russianrovercup/kosmo-arm/media/kosmo-arm-r1.jpg

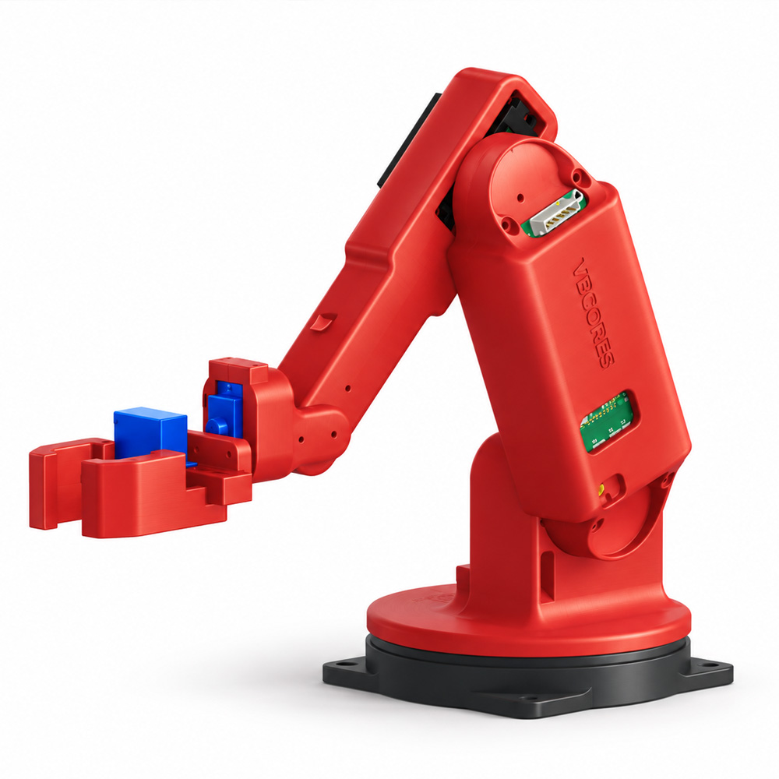
media/kosmo-arm-r1.jpg
