russianrovercup/kosmo-arm/media/stl-previews/overview.png

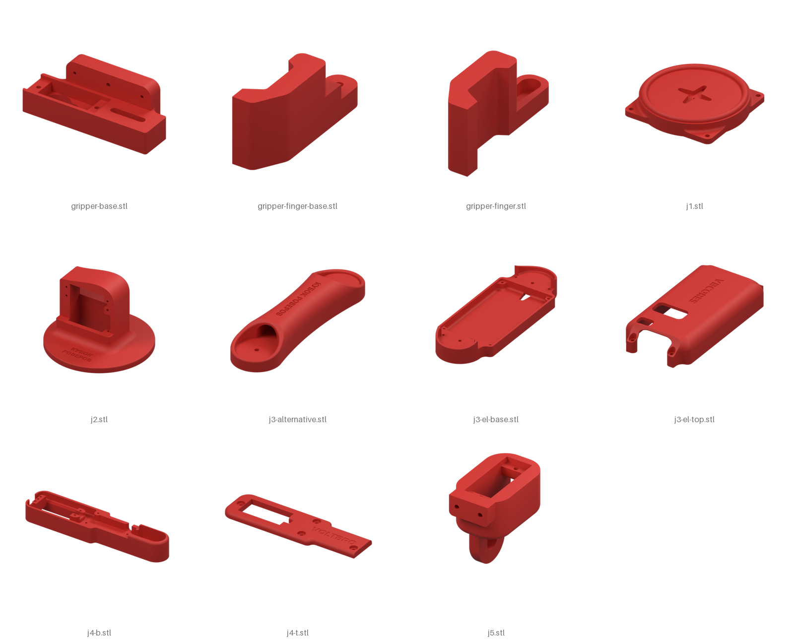
media/stl-previews/overview.png
