russianrovercup/kosmo-arm/step/Assembly_KOSMO_Arm.stp

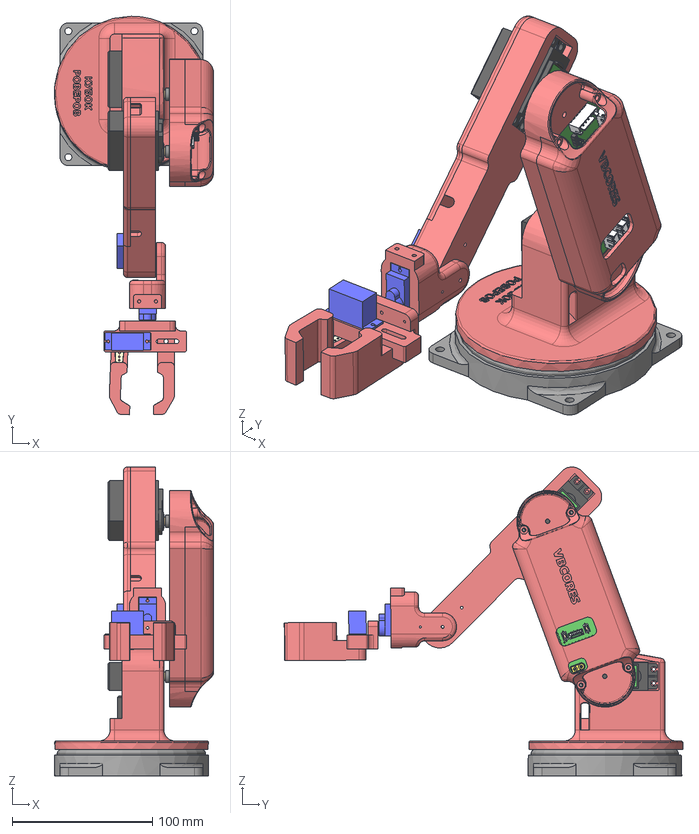
[picture p17: CAD file, 2026-10-02]
step/Assembly_KOSMO_Arm.stp
113.7 x 284.6 x 220.7 mm
MG995-180 x 3
MicroServo-Arm x 3
MicroServo x 3
gripper-base
gripper-finger
gripper-finger-base
j5
j4-b
j2
j1
StdServo-X-arm x 3
j4-t
j3-el-base
vb-servoboard
VBcoreG474
B06MB-GHS-TBT
G73_button x 2
XH-3A x 8
XH-6A x 2
XH-7A
XH-5A
pls-3 x 8
XT30
j3-el-top
