russianrovercup/kosmo-arm/stl/gripper-finger.stl

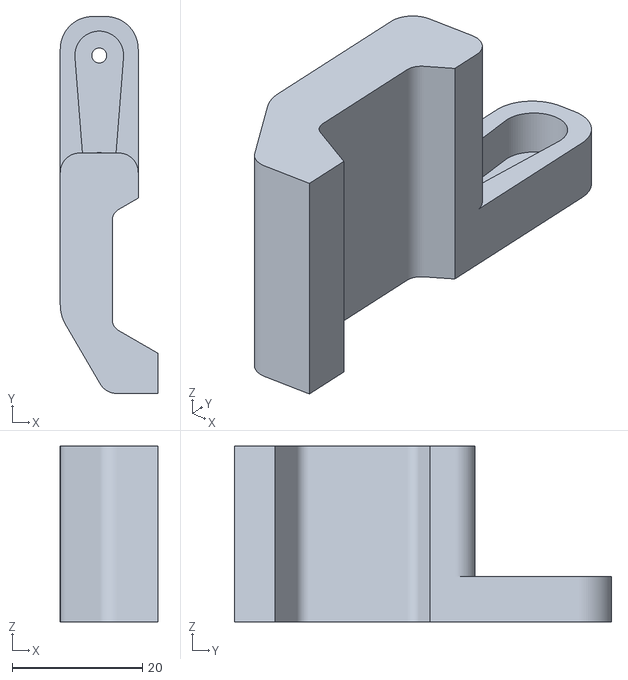
[picture p18: CAD file, 2026-10-02]
stl/gripper-finger.stl
15.0 x 58.0 x 27.0
