russianrovercup/kosmo-arm/stl/j3-el-top.stl

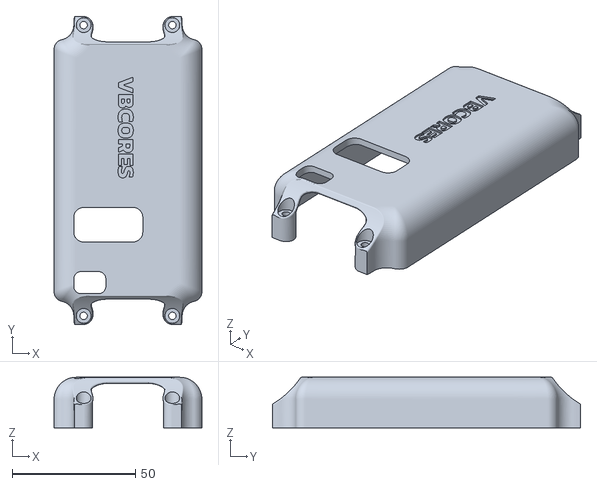
[picture p19: CAD file, 2026-10-02]
stl/j3-el-top.stl
60.0 x 125.0 x 20.5
