russianrovercup/kosmo-arm/stl/j4-b.stl

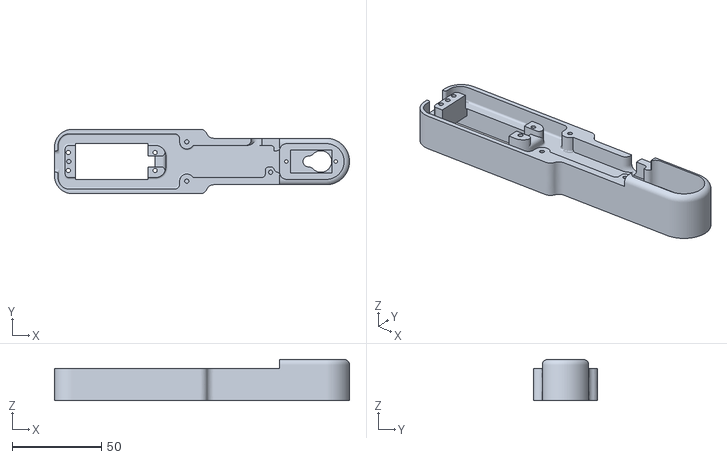
[picture p20: CAD file, 2026-10-02]
stl/j4-b.stl
165.0 x 36.0 x 23.0
