russianrovercup/kosmo-arm/stl/gripper-finger-base.stl

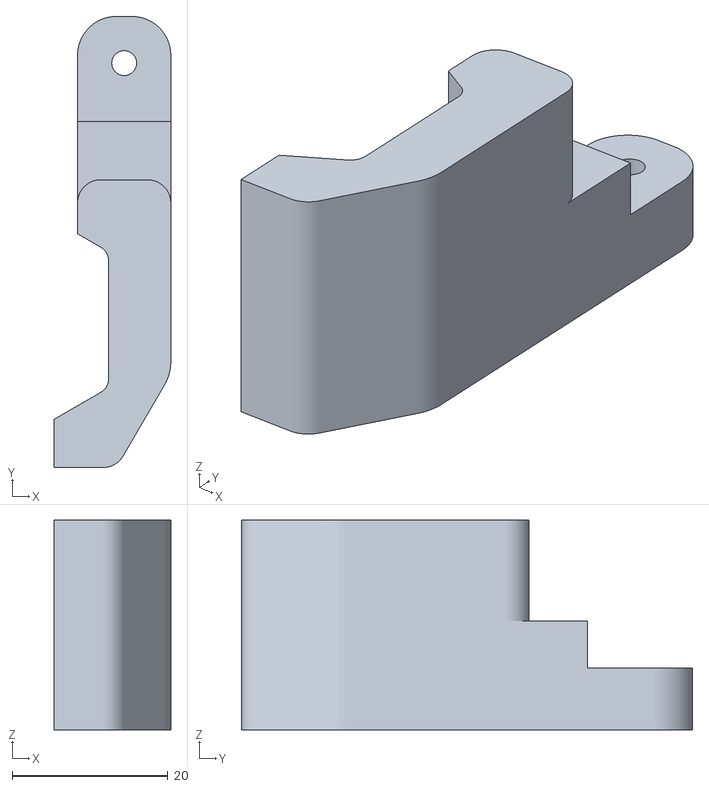
[picture p21: CAD file, 2026-10-02]
stl/gripper-finger-base.stl
15.0 x 58.0 x 27.0
