russianrovercup/kosmo-arm/stl/gripper-base.stl

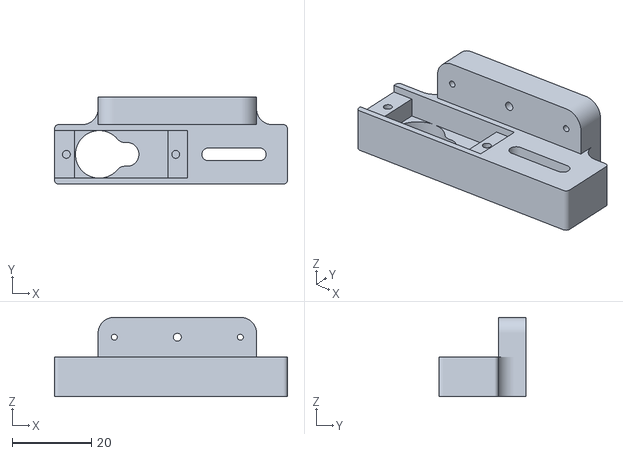
[picture p22: CAD file, 2026-10-02]
stl/gripper-base.stl
58.8 x 22.0 x 20.0
