russianrovercup/kosmo-arm/stl/j1.stl

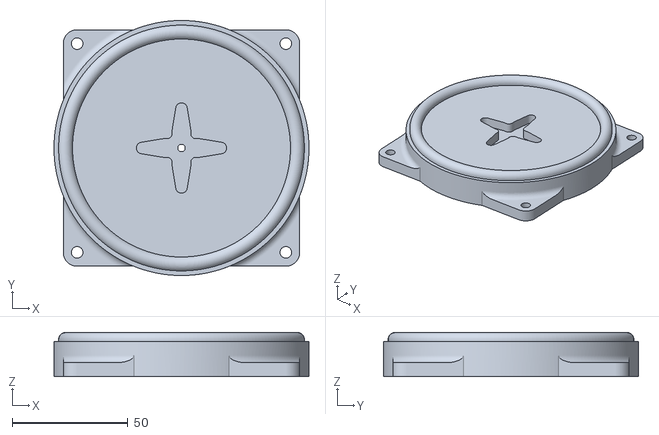
[picture p23: CAD file, 2026-10-02]
stl/j1.stl
110.0 x 110.0 x 19.0
