russianrovercup/kosmo-arm/stl/j4-t.stl

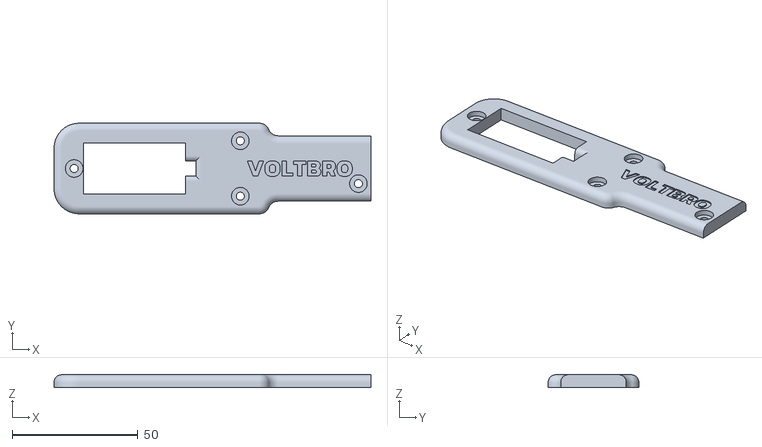
[picture p24: CAD file, 2026-10-02]
stl/j4-t.stl
125.9 x 36.0 x 5.00
