russianrovercup/kosmo-arm/stl/j5.stl

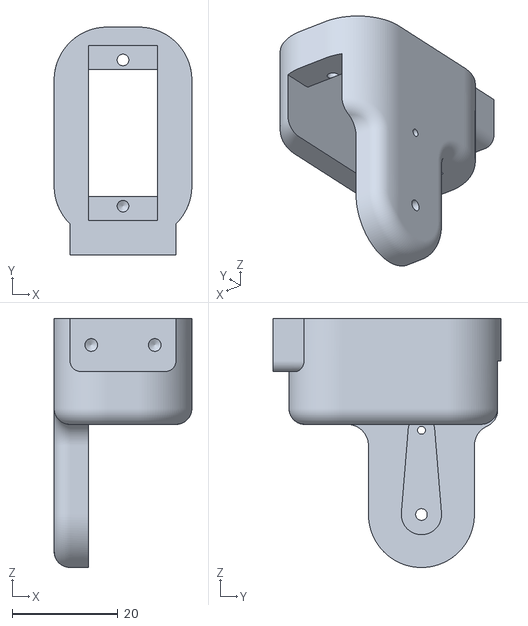
[picture p25: CAD file, 2026-10-02]
stl/j5.stl
26.0 x 43.0 x 47.0
