russianrovercup/kosmo-arm/stl/j2.stl

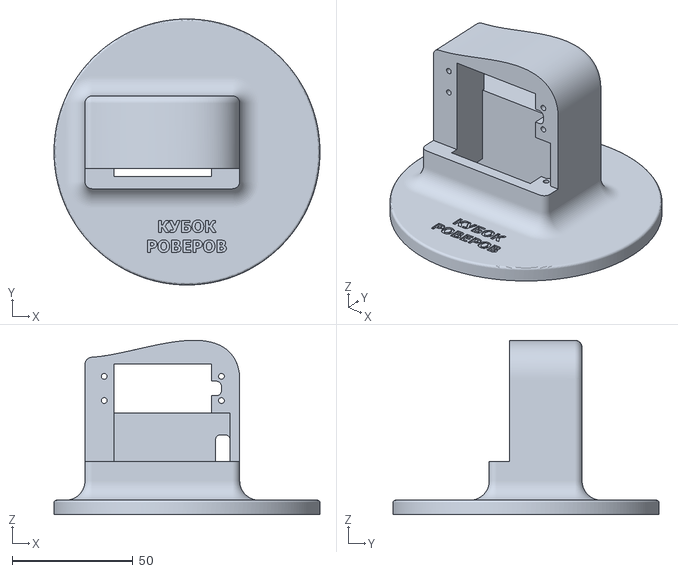
[picture p26: CAD file, 2026-10-02]
stl/j2.stl
110.0 x 110.0 x 72.1
