russianrovercup/kosmo-arm/stl/j3-el-base.stl

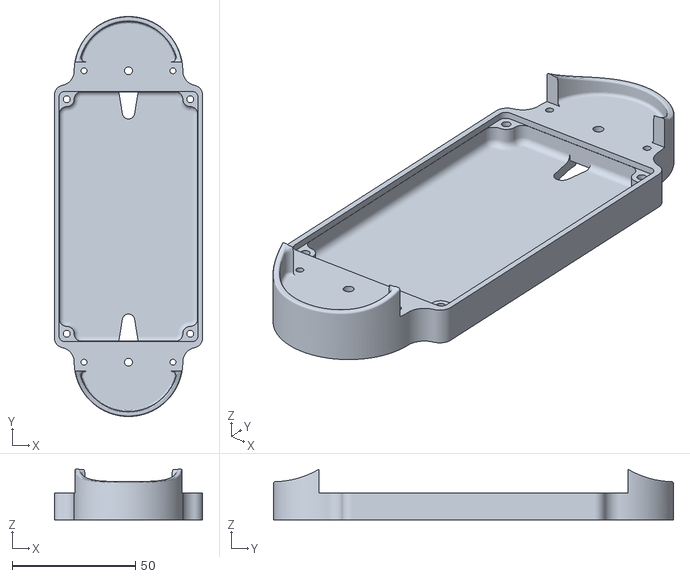
[picture p27: CAD file, 2026-10-02]
stl/j3-el-base.stl
60.0 x 162.0 x 20.6
