russianrovercup/kosmo-arm/stl/j3-alternative.stl

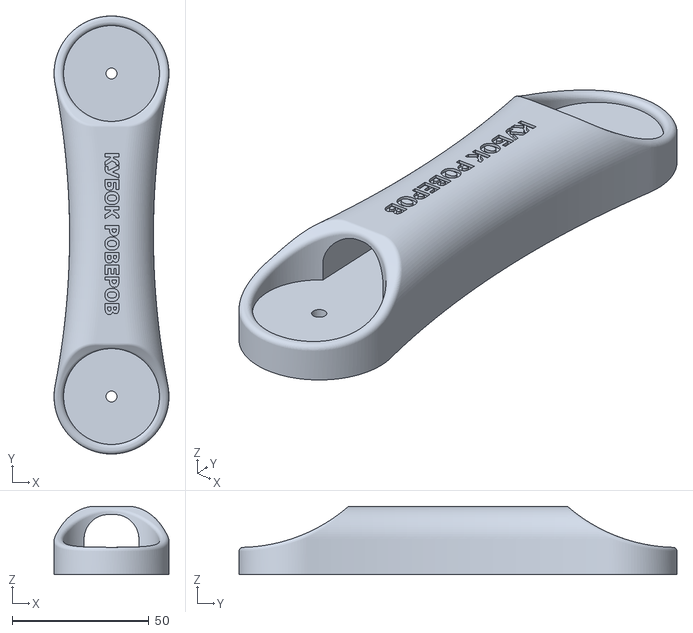
[picture p28: CAD file, 2026-10-02]
stl/j3-alternative.stl
42.0 x 160.0 x 25.0
